vlaate/SkyWatcherWiFi/(threads)

Thread 1 (2019-06-17):

Thanks

WheresWally, 2019-06-17:
Just wanted to say thanks.
I will give it a crack.
Looks amazingly simple.
I use OTA updates via the TCPIP so I dont need to connect physically to reprogram.

WheresWally, 2019-06-18:
Quick Question
Why did you decide to use the hardware serial to talk to the mount?
It should work using software serial yes? It is slow at 9800 and not very intensive on the character loading.
I am going to try it on software serial and using different pins.
Thanks so much.

vlaate, 2019-06-18:
I developed it using software serial on some other pins, so that I could use the hardware serial for debugging (printing logs to the Arduino IDE's serial monitor). It does work fine that way, rest assured.

I think I changed it after it was finished, just to make the circuit simpler, for publication.

WheresWally, 2019-06-18:
I am about to wire it up to my ESP8266-12E mini board. I made some PCB to take the ESP8266 and I have used that in a few places, a 240V wifi remote power socket was one.
I will send you pics and the code once I have it working.

WheresWally, 2019-06-20:
https://youtu.be/IfjURPJxaTo

and some of the debug while using the pan button
https://imgur.com/bOPqxVL

I want to tidy up the code a bit more. Then I can upload it.
This program does OTA updates so no direct connection needed.
It also has a web interface to display the debug data.
It keeps the last 2000 characters of debug.

WheresWally, 2019-06-20:
The softwareSerial did not work until I went from 2.3.0 to 2.5.2
There were a few other fun and games along the way too.

vlaate, 2019-06-20:
Interesting.

Did you do something to get the pan buttons on the app to work?

WheresWally, 2019-06-20:
NOPE, That is why I thought you would be interested.
I pretty much just used the UDP<-->Serial code as you had it. Did not change or even look at the chars you were ignoring etc.

Thread 2 (2019-08-20):

Pinout

aposonidis, 2019-08-20:
2 questions:
1st: Is the pinout correct? as in schematic you are showing GPIO1 & 3 but in the comments and the README, you're mentioning GPIO13, 15
2nd: Why are you using the resistors for the Tx/Rx lines?
thank you

vlaate, 2019-08-20:
The Schematic is correct, it's GPIO 1 & 3, see source code line 68.

The comments in the source need updating to the latest pinout, I'll fix them

Closed 2019-12-26.

Thread 3 (2019-12-26):

SkyWatcherWiFi and Kstars

rigelinorion, 2019-12-26:
Hello. Thank you for sharing your project. Works great with the SkyWatcher mobile app. However, wanting to run it with the KStars program under Ubuntu I had a lot of problems to connect the telescope via wifi. There was no problem when connecting directly via serial port so I came up with the idea to modify your code. I removed the lines responsible for checking communication and ... works !!! Maybe someone will need this tip. Once again, thank you for sharing the project and best regards.

vlaate, 2019-12-26:
Hi.

Which lines of code did you remove?

rigelinorion, 2019-12-26:
This is the code I use to connect KStars with Virtuoso...

void kstars_protocol(){
  int packetSize = udp.parsePacket();
  if (packetSize > 0) // when data arrives via WiFi
  {
    // take note of address and port to send our response to:
    remoteIp = udp.remoteIP();
    UDPremoteudpPort = udp.remotePort();

    udp.read(udpBuffer, bufferSize); //read the incoming data

    Serial.write(udpBuffer, packetSize);  // forward the recieved data straight to the serial connection to the telescope mount
    ignore = true;    // we need to ignore the first characters that we get from the telescope mount (an echo of our command / garbage) until we get the "=" character that signals the beginning of the actual response
  }

  if (Serial.available()) // when data arrives from the mount via the serial port
  {

    while(Serial.available() > 0)
    {
        byte data = Serial.read();
        serialBuffer[serialIndex] = data;
        if (serialIndex < bufferSize - 1)
          {
            serialIndex++;
          }
    }

    // Now we send the message recieved from the telescope mount, as an UDP packet to the client app (via WiFi):
    udp.beginPacket(remoteIp, UDPremoteudpPort);
    udp.write(serialBuffer, serialIndex);
    udp.endPacket();
    yield();
    serialIndex = 0;
  }
}

rigelinorion, 2019-12-28:
Welcome back. Strange thing. I used the ESP32_CAM module in standard wifi mode connecting via router and cannot connect kstars to mount. In AP mode it works without any problem after modifying the code. Do you have any screenshots of the eavesdropping protocol? It would help me figure out the problem.
