vlaate/SkyWatcherWiFi/SkyWatcherWiFi.ino

/*
  Serial to WiFi adapter for Skywatcher telescopes
  This is an adapter to connect to the RJ-11 udpPort of Skywatcher telescope mounts
  and offer the serial connection as an UDP udpPort 11880 via WiFi to the Skywatcher Synscan app.
  Copyright (c) 2019 Vladimir Atehortua. All rights reserved.
  This program is free software: you can redistribute it and/or modify
  it under the terms of the version 3 GNU General Public License as
  published by the Free Software Foundation.
  This program is distributed in the hope that it will be useful,
  but WITHOUT ANY WARRANTY; without even the implied warranty of
  MERCHANTABILITY or FITNESS FOR A PARTICULAR PURPOSE.  See the
  GNU General Public License for more details.
  You should have received a copy of the GNU General Public License along with this program.
  If not, see <http://www.gnu.org/licenses/>
*/

/**
    Hardware used:
    NodeMCU ESP8266 development board (version 12E) I used the HiLetgo model https://www.amazon.com/gp/product/B010O1G1ES 
    100 Ohm resistor
    50 Ohm resistor (or two 100 Ohm resistors in parallel)
    RJ11 Pinout:
        --- No Connection
        --- GND
        --- "TX" to a 50 Ohm resistor and then to NodeMCU's pin TX (GPIO_1)
        --- VCC 12V (to a 5V drop-down volate regulator to power the NodeMCU thrugh it's Vin pin)
        --- "RX" to a 100 Ohm resistor and then to NodeMCU's pin RX (GPIO_3)
        --- No Connection
    
    ESP8266 pinout:
     GND:  To the GND pin of the RJ11 connector (and to GND of your chosen power source)

     When not connected to a computer via USB:
     Vin:  5V~9V from any power source (you can use a step down from 12V to ~5V to power the NodeMCU from most skywatcher mounts)
     TX:   to a 50 Ohm resstor and then to the "TX" pin on the RJ11 connector
     RX:   to a 100 Ohm resistor and then to the "RX" pin on the RJ11 connector
*/

#include <ESP8266WiFi.h>
#include <WiFiUdp.h>

#define mountBaudRate 9600
#define loggerBaudRate 115200
#define timeOut 20 // ms (if nothing more on UART, then send packet)
#define bufferSize 8192

#define WiFi_Access_Point_Name "SynScan_WiFi_1234"   // Name of the WiFi access point this device will create for your tablet/phone to connect to.
#define udpPort 11880 // UDP udpPort expected by SynScan
WiFiUDP udp;
IPAddress remoteIp;
int UDPremoteudpPort;

uint8_t udpBuffer[bufferSize];
uint8_t udpIndex = 0;

uint8_t serialBuffer[bufferSize];
uint8_t serialIndex = 0;

boolean ignore = true;  // Because the mount connection seems to share the wire for RX and TX, commands sent to the mount are recieved back, as an "echo", and must be ignored.

void setup() {
  Serial.begin(mountBaudRate);

  WiFi.mode(WIFI_AP);
  IPAddress ip(192, 168, 4, 1);
  IPAddress subnet(255, 255, 255, 0);
  WiFi.softAPConfig(ip, ip, subnet);
  WiFi.softAP(WiFi_Access_Point_Name); // configure ssid and password for softAP
  udp.begin(udpPort);
}

void loop()
{
  int packetSize = udp.parsePacket();
  if (packetSize > 0) // when data arrives via WiFi
  {
    // take note of address and port to send our response to:
    remoteIp = udp.remoteIP();
    UDPremoteudpPort = udp.remotePort();

    udp.read(udpBuffer, bufferSize); //read the incoming data

    Serial.write(udpBuffer, packetSize);  // forward the recieved data straight to the serial connection to the telescope mount
    ignore = true;    // we need to ignore the first characters that we get from the telescope mount (an echo of our command / garbage) until we get the "=" character that signals the beginning of the actual response
  }

  if (Serial.available()) // when data arrives from the mount via the serial port
  {
    Serial.read();
    while (true)
    {
      if (Serial.available()) 
      {
        byte data = Serial.read();

        if (data == 61 || data == 33) // if the character that arrived is the character "=" or "!", it marks the beginning of the actual mount response, so we stop ignoring the data
        {
          ignore = false;
        }

        if (!ignore)  // if the data is not to be ignored, we accumulate it in the buffer
        {
          serialBuffer[serialIndex] = data; 
          if (serialIndex < bufferSize - 1)
          {
            serialIndex++;
          }
        }
      } else 
      {
        delay(timeOut); // let's give a small wait for more data to arrive
        if (!Serial.available()) {
          break;    // if after the delay no mor data arrived, we quit the loop (reason: timeout)
        }
      }
    }

    // Now we send the message recieved from the telescope mount, as an UDP packet to the client app (via WiFi):
    udp.beginPacket(remoteIp, UDPremoteudpPort); 
    udp.write(serialBuffer, serialIndex);
    udp.endPacket();
    yield();
    serialIndex = 0;
  }
}
