vlaate/SkyWatcherWiFi/(commit log)

2019-04-01 Initial commit
    initial version, tested and operational on my virtuoso mount
2019-04-01 added support for "error responses" which begin with the character ! instead of =, according to the skywatcher manual
    [SkyWatcherWiFi.ino]
2019-08-20 Update SkyWatcherWiFi.ino
    Fix pins
    [SkyWatcherWiFi.ino]
2019-08-20 Update SkyWatcherWiFi.ino
    Pin changes
2019-09-20 fixed Serial.swap inconsistency with circuit, removed log
    [SkyWatcherWiFi.ino]
